spandananupam/single-photon/README.md

# Inexpensive Single Photon Detection Circuit with AND114R LEDs
The codebase and report for a single photon detector made in 2020-21 as part of the course P441-442 at NISER, Bhubaneswar.
