spandananupam/single-photon/report/images/circuit.pdf

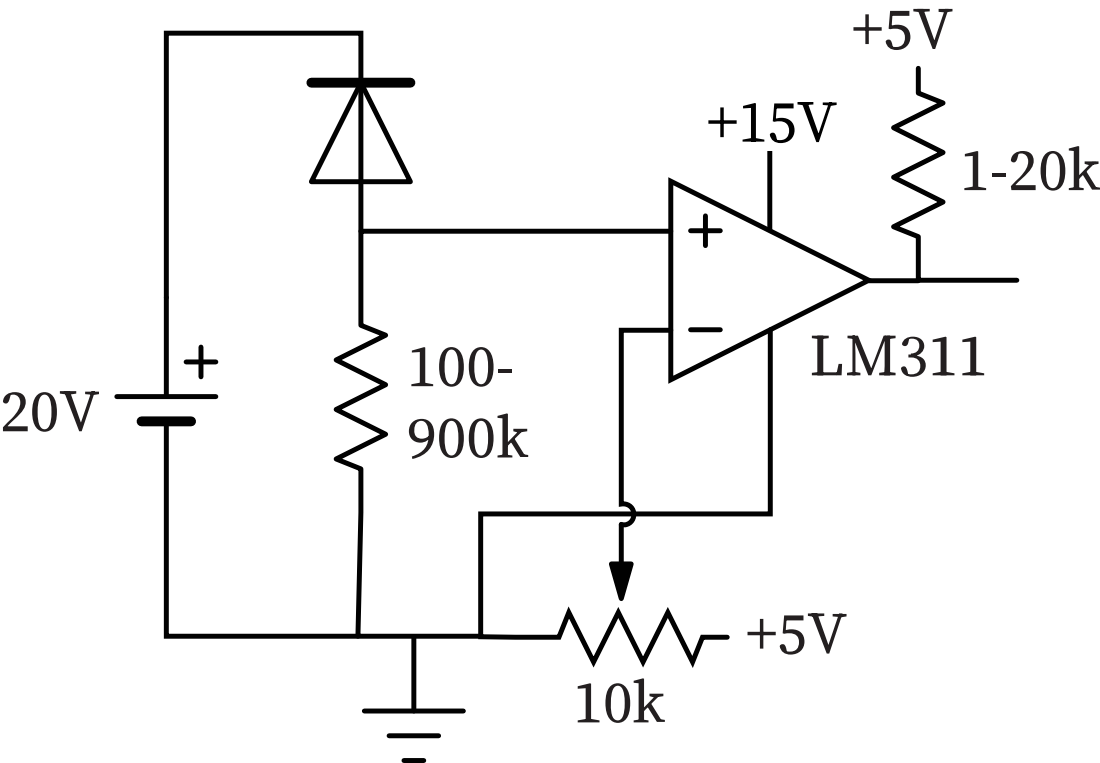
[picture p12: page 1]
