spandananupam/single-photon/report/images/model.pdf

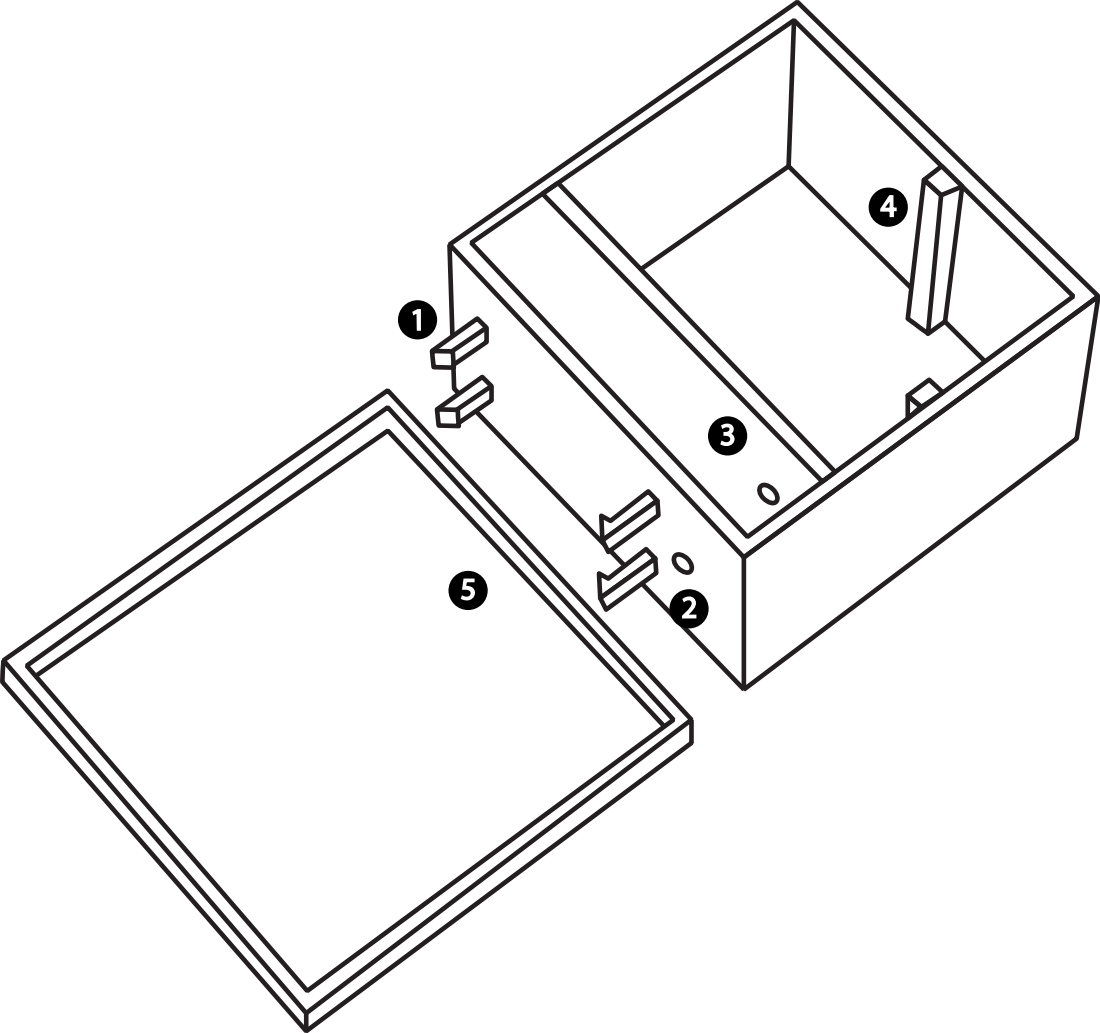
[picture p13: page 1]
