spandananupam/single-photon/report/images/setup.pdf

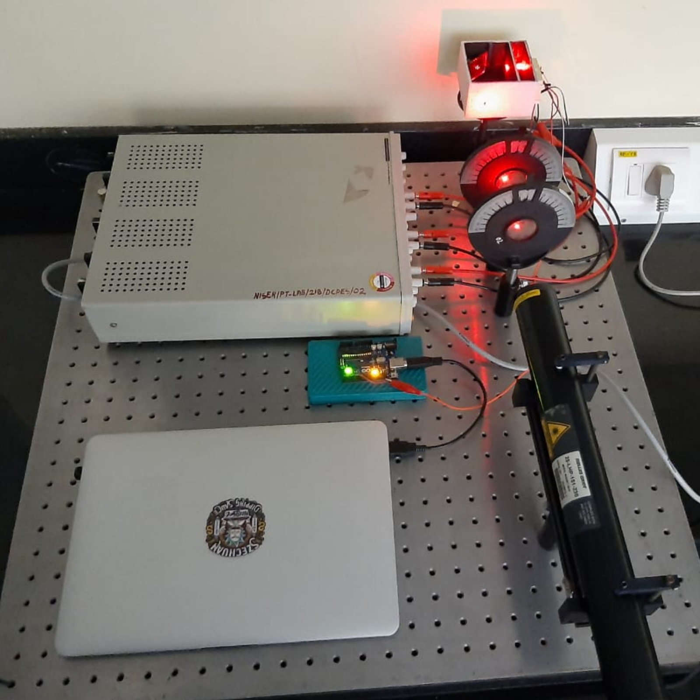
[picture p14: page 1]
